MayFly-AI/stm32-pi4-hw/README.md

This repository contains 

- KiCad files for Raspberry Pi HAT Pose sensor
- KiCad files for STM32 Pose sensor
- STL files for camera enclosure
- STL files for enclosure for STM32 Pose sensor

We have used JLCPCB for producing the PCBs and the enclosures.
