MayFly-AI/stm32-pi4-hw/3d/pi4/base-pla.stl

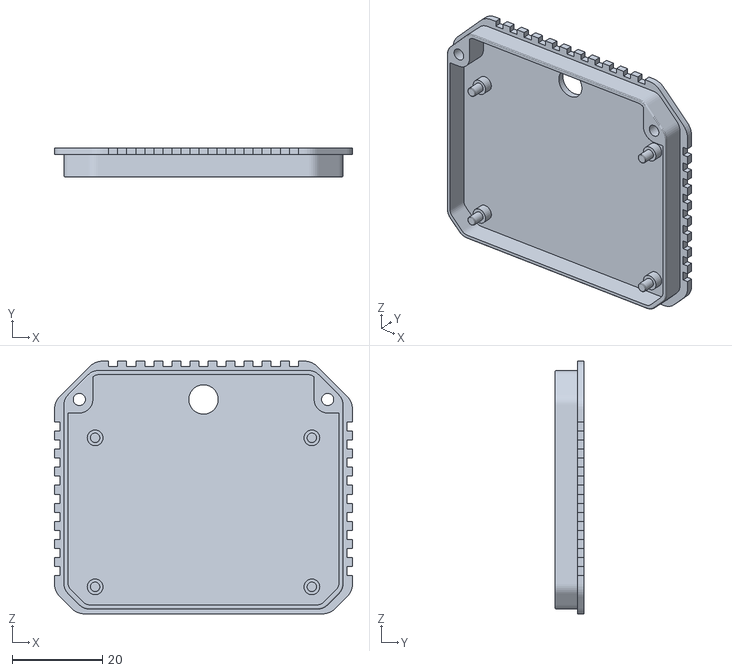
[picture p1: CAD file, 2024-03-07]
3d/pi4/base-pla.stl
66.0 x 6.50 x 56.0
