MayFly-AI/stm32-pi4-hw/3d/stm32/lid.stl

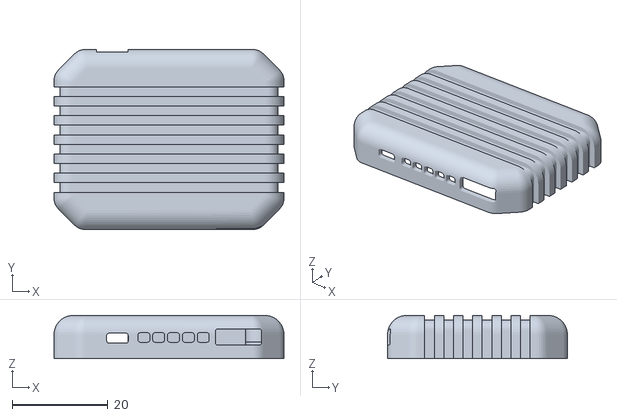
[picture p2: CAD file, 2024-02-19]
3d/stm32/lid.stl
48.0 x 37.6 x 9.00
