MayFly-AI/stm32-pi4-hw/3d/pi4/base-alu.stl

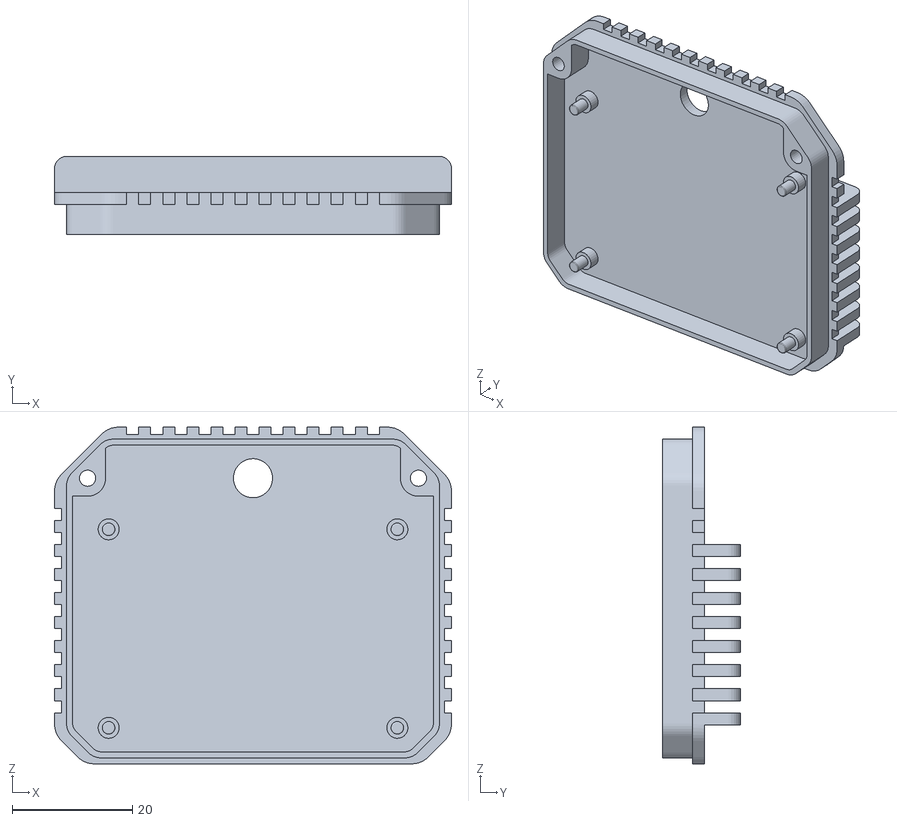
[picture p3: CAD file, 2024-03-07]
3d/pi4/base-alu.stl
66.0 x 13.0 x 56.0
