MayFly-AI/stm32-pi4-hw/3d/stm32/base.stl

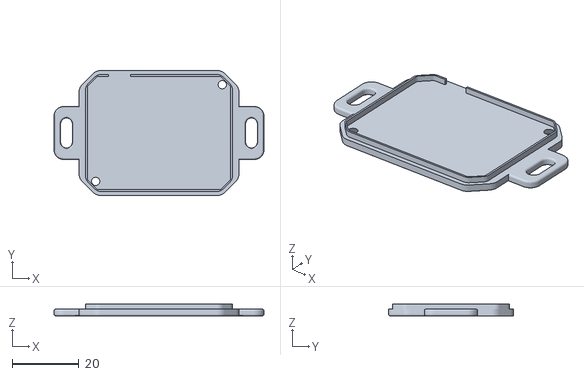
[picture p4: CAD file, 2024-02-19]
3d/stm32/base.stl
63.0 x 37.5 x 3.50
