MayFly-AI/stm32-pi4-hw/3d/pi4/lid.stl

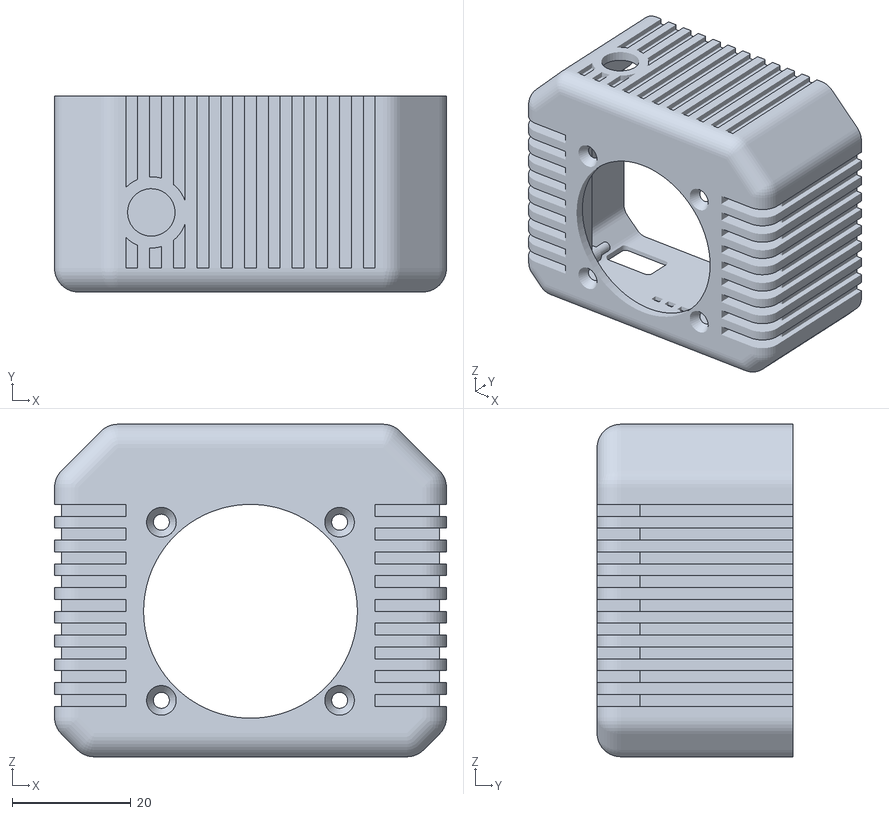
[picture p5: CAD file, 2024-02-29]
3d/pi4/lid.stl
66.0 x 33.0 x 56.0
