MayFly-AI/stm32-pi4-hw/(list of files, cad)

Other CAD files:
3d/pi4/pi4-sensorleap-pro.f3d
3d/stm32/stm32-sensorleap-box-v12.f3d
