MayFly-AI/stm32-pi4-hw/pcb/stm32f405-sensorleap-pro-v1/stm32f405-sensorleap-pro-v1.kicad_pcb

## KiCad design pcb/stm32f405-sensorleap-pro-v1/stm32f405-sensorleap-pro-v1.kicad_pcb (2024-02-20)

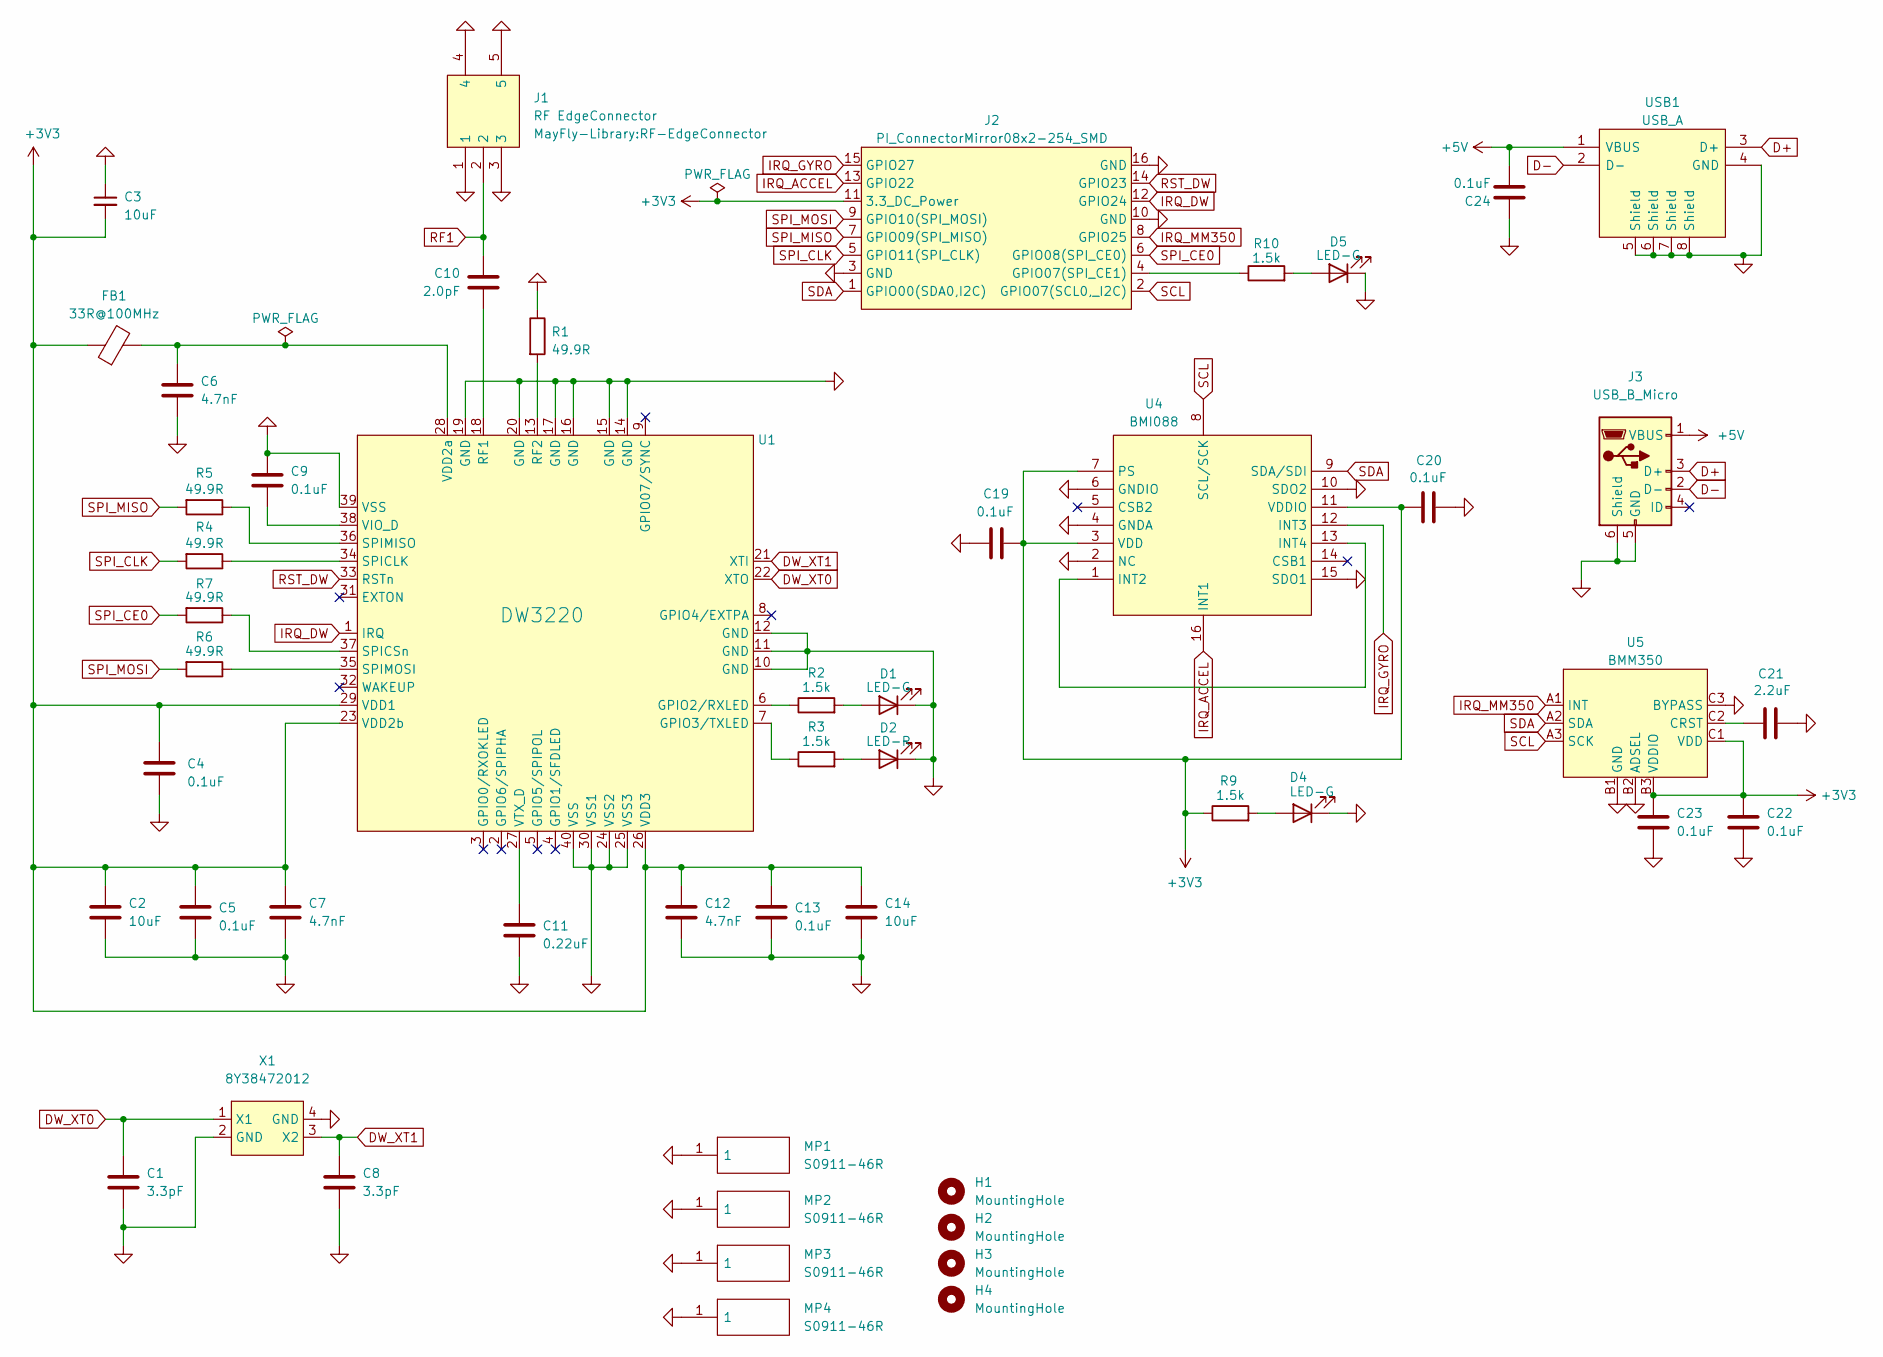
[picture p6: schematic stm32f405-sensorleap-pro-v1.kicad_sch]

Parts:
C1, C8: 3.3pF; C_0402_1005Metric; Mouser 81-GJM1555C1H3R3WB1D
C2, C14: 10uF; C_0402_1005Metric; Mouser 81-GRM155R61A106ME1D
C3: 10uF; C_0603_1608Metric; Mouser 81-GRM188R60J106ME47
C4, C5, C9, C13, C19, C20, C22, C23, C24: 0.1uF; C_0402_1005Metric; Mouser 810-C1005X7R1H104KBE
C6, C7, C12: 4.7nF; C_0402_1005Metric; Mouser 81-GCM155R71H472K37D
C10: 2.0pF; C_0402_1005Metric; Mouser 81-GJM1555C1H2R0WB1D
C11: 0.22uF; C_0402_1005Metric; Mouser 81-GRM155R71A224KE1D
C21: 2.2uF; C_0805_2012Metric; Mouser 81-GCM21BR71A225KA7L
D1, D4, D5: LED-G; LED_0603_1608Metric; LCSC C264453
D2: LED-R; LED_0603_1608Metric; LCSC C181863
FB1: 33R@100MHz; L_0402_1005Metric; Mouser 81-BLM15PX330SZ1D
H1, H2, H3, H4: MountingHole; MountingHole_2.5mm
J1: RF EdgeConnector; RF-EdgeConnector
J2: PI_ConnectorMirror08x2-254_SMD; PI_Connector08x2-254_SMD; LCSC C5160823
J3: USB_B_Micro; USB_Micro-AB_Molex_47590-0001; LCSC C136001
MP1, MP2, MP3, MP4: S0911-46R; S091146R; Mouser Part Number 855-S0911-46R
R1, R4, R5, R6, R7: 49.9R; R_0402_1005Metric; Mouser 667-ERJ-2RKF49R9X
R2, R3, R9, R10: 1.5k; R_0402_1005Metric; Mouser 667-ERJ-2RKF1501X
U1: DW3220; QFN-40_5x5_Pitch0.4mm; Mouser 772-DW3220TR13
U4: BMI088; Mouser :262-BMI088
U5: BMM350; LCSC C7496950
USB1: USB_A; 629104190121; Mouser Part Number 710-629104190121
X1: 8Y38472012; LCSC C2450882

Connections:
+3V3: C2.1, C3.2, C4.1, C5.1, C7.1, C12.1, C13.1, C14.1, C19.2, C20.1, C22.1, C23.1, FB1.1, J2.11 (3.3_DC_Power), R9.1, U1.23 (VDD2b), U1.26 (VDD3), U1.29 (VDD1), U4.3 (VDD), U4.7 (PS), U4.11 (VDDIO), U5.B3 (VDDIO), U5.C1 (VDD)
+5V: C24.2, J3.1 (VBUS), USB1.1 (VBUS)
D+: J3.3 (D+), USB1.3 (D+)
D-: J3.2 (D-), USB1.2 (D-)
DW_XT0: C1.1, U1.22 (XTO), X1.1 (X1)
DW_XT1: C8.1, U1.21 (XTI), X1.3 (X2)
GND: C1.2, C2.2, C3.1, C4.2, C5.2, C6.2, C7.2, C8.2, C9.1, C11.2, C12.2, C13.2, C14.2, C19.1, C20.2, C21.2, C22.2, C23.2, C24.1, D1.1 (K), D2.1 (K), D4.1 (K), D5.1 (K), J1.1, J1.3, J1.4, J1.5, J2.3 (GND), J2.10 (GND), J2.16 (GND), J3.5 (GND), J3.6 (Shield), MP1.1, MP2.1, MP3.1, MP4.1, R1.1, U1.10 (GND), U1.11 (GND), U1.12 (GND), U1.14 (GND), U1.15 (GND), U1.16 (GND), U1.17 (GND), U1.19 (GND), U1.20 (GND), U1.24 (VSS2), U1.25 (VSS3), U1.30 (VSS1), U1.39 (VSS), U1.40 (VSS), U4.2 (NC), U4.4 (GNDA), U4.6 (GNDIO), U4.10 (SDO2), U4.15 (SDO1), U5.B1 (GND), U5.B2 (ADSEL), U5.C3 (BYPASS), USB1.4 (GND), USB1.5 (Shield), USB1.6 (Shield), USB1.7 (Shield), USB1.8 (Shield), X1.2 (GND), X1.4 (GND)
IRQ_ACCEL: J2.13 (GPIO22), U4.16 (INT1)
IRQ_DW: J2.12 (GPIO24), U1.1 (IRQ)
IRQ_GYRO: J2.15 (GPIO27), U4.12 (INT3)
IRQ_MM350: J2.8 (GPIO25), U5.A1 (INT)
unnamed: D1.2 (A), R2.2
unnamed: D2.2 (A), R3.2
unnamed: D4.2 (A), R9.2
unnamed: D5.2 (A), R10.2
unnamed: J2.4 (GPIO07(SPI_CE1)), R10.1
unnamed: R2.1, U1.6 (GPIO2/RXLED)
unnamed: R3.1, U1.7 (GPIO3/TXLED)
unnamed: C10.2, U1.18 (RF1)
unnamed: R1.2, U1.13 (RF2)
unnamed: R4.1, U1.34 (SPICLK)
unnamed: R7.1, U1.37 (SPICSn)
unnamed: R5.1, U1.36 (SPIMISO)
unnamed: R6.1, U1.35 (SPIMOSI)
unnamed: C6.1, FB1.2, U1.28 (VDD2a)
unnamed: C9.2, U1.38 (VIO_D)
unnamed: C11.1, U1.27 (VTX_D)
unnamed: U4.1 (INT2), U4.13 (INT4)
unnamed: C21.1, U5.C2 (CRST)
RF1: C10.1, J1.2
RST_DW: J2.14 (GPIO23), U1.33 (RSTn)
SCL: J2.2 (GPIO07(SCL0,_I2C)), U4.8 (SCL/SCK), U5.A3 (SCK)
SDA: J2.1 (GPIO00(SDA0,I2C)), U4.9 (SDA/SDI), U5.A2 (SDA)
SPI_CE0: J2.6 (GPIO08(SPI_CE0)), R7.2
SPI_CLK: J2.5 (GPIO11(SPI_CLK)), R4.2
SPI_MISO: J2.7 (GPIO09(SPI_MISO)), R5.2
SPI_MOSI: J2.9 (GPIO10(SPI_MOSI)), R6.2

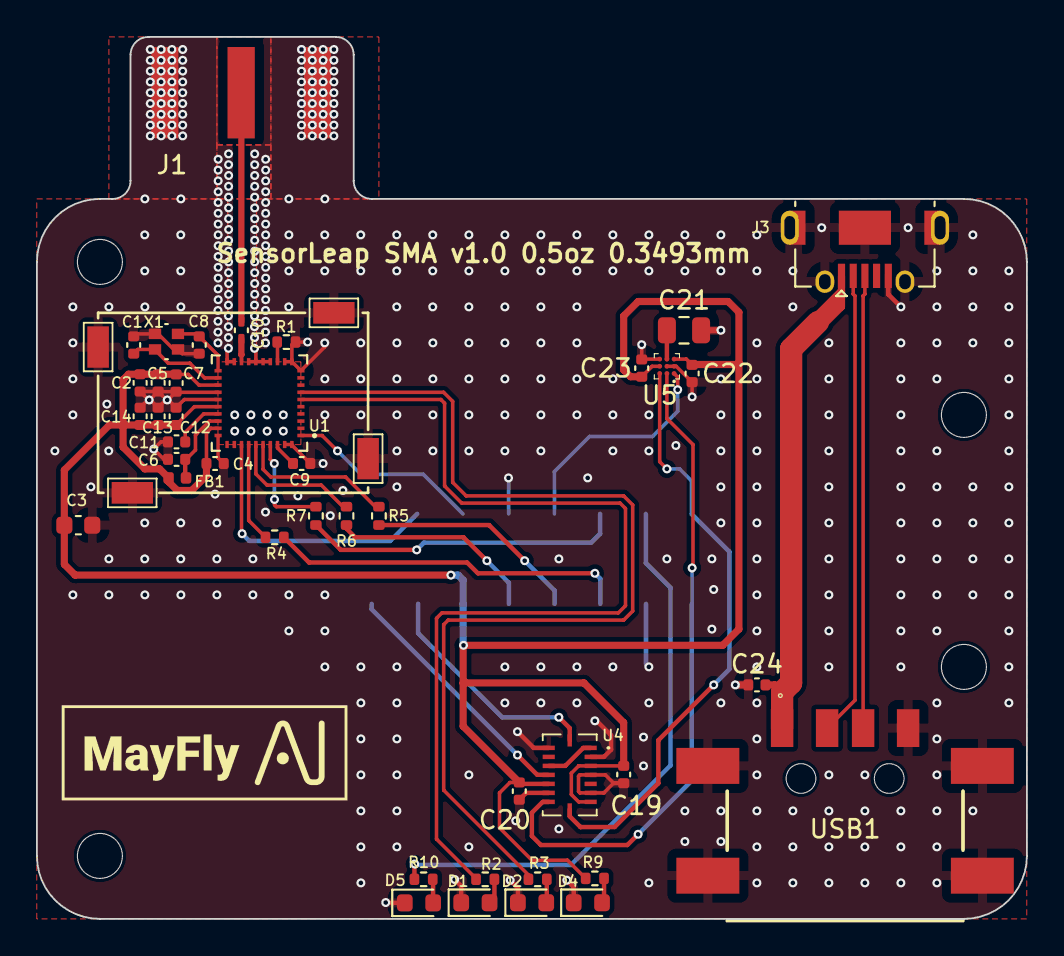
[picture p7: board stm32f405-sensorleap-pro-v1.kicad_pcb from above]

Board: 4 copper layers, 55.0 x 49.0 mm, 50 parts (1 on the bottom side), 37 nets.
