MayFly-AI/stm32-pi4-hw/pcb/stm32f405-sensorleap-v1/stm32f405-sensorleap-v1.kicad_pcb

## KiCad design pcb/stm32f405-sensorleap-v1/stm32f405-sensorleap-v1.kicad_pcb (2024-02-19)

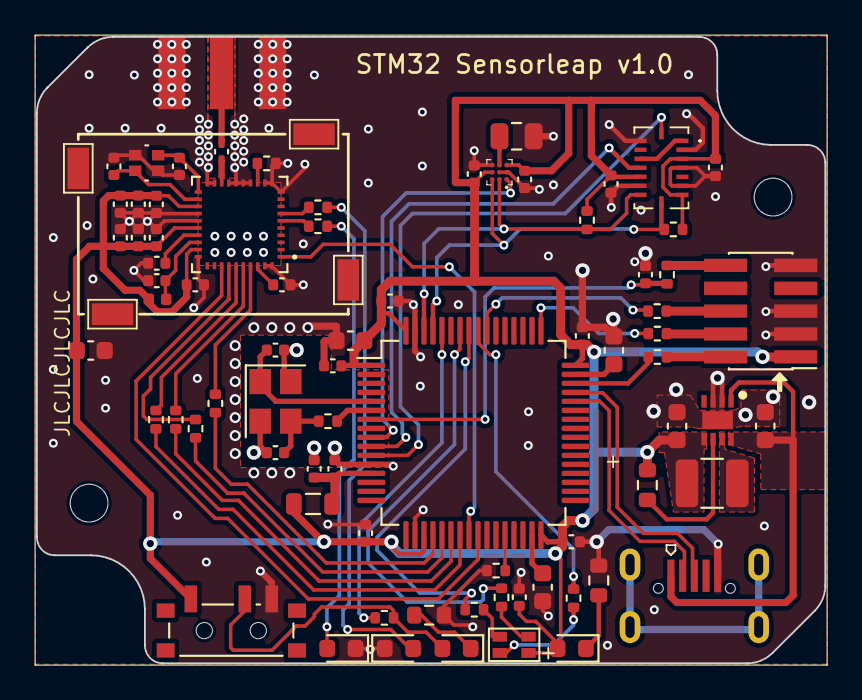
[picture p8: board stm32f405-sensorleap-v1.kicad_pcb from above]

Board: 4 copper layers, 43.8 x 34.8 mm, 82 parts (0 on the bottom side), 61 nets.

Parts:
C1, C301: 10uF; C_0603_1608Metric
C2, C14: 10uF; C_0402_1005Metric
C3, C9: 3.3pF; C_0402_1005Metric
C4, C6, C7, C13, C15, C16, C18, C19: 0.1uF; C_0402_1005Metric
C5, C8, C12: 4.7nF; C_0402_1005Metric
C10: 2.0pF; C_0402_1005Metric
C11: 0.22uF; C_0402_1005Metric
C20: 2.2uF; C_0805_2012Metric
C200: 4u7; C_0603_1608Metric
C201, C202, C203, C204, C205, C212, C400: 100n; C_0402_1005Metric
C206: 1u; C_0402_1005Metric
C207: 10n; C_0402_1005Metric
C208, C209: 2u2; C_0603_1608Metric
C210, C211: 12p; C_0402_1005Metric
C302: 22uF; C_0603_1608Metric
D1, D102: LED-G; LED_0603_1608Metric
D2, D200: LED-R; LED_0603_1608Metric
D201: 19-237/R6GHBHC-A01/2T; 19-237-R6GHBHC-A01-2T
FB1: 33R@100MHz; L_0402_1005Metric
FB200: 600 @ 600 MHz; L_0805_2012Metric
H1, H2: MountingHole; MountingHole_2.1mm
J1: RF EdgeConnector; CON-SMA-EDGE-SRP
J401: SWD; PinHeader_2x05_P1.27mm_Vertical_SMD
J402: USB_B_Micro; 5P Female Micro-B C40943
L1: 1uH; L_1210_3225Metric
MP1, MP2, MP3, MP4: S0911-46R; S091146R
R1, R2, R3, R4, R5: 49.9R; R_0402_1005Metric
R6, R206, R207, R208: 1k; R_0402_1005Metric
R7: 1.5k; R_0402_1005Metric
R105: 1k5; R_0603_1608Metric
R200: 47R; R_0402_1005Metric
R201, R203: 10k; R_0402_1005Metric
R202: 1k; R_0603_1608Metric
R204, R205: 2k2; R_0402_1005Metric
R301: 180k; R_0603_1608Metric
R400, R401, R402, R403: 22R; R_0402_1005Metric
SW200: SW_SPDT; SW_SPDT_PCM12
U1: DW3220; QFN-40_5x5_Pitch0.4mm
U2: BMI088
U3: BMM350
U200: STM32F405RGT6; LQFP-64_10x10mm_P0.5mm
U301: TPS62082; SON50P200X200X80-9N
X1: 8Y38472012
Y200: 16MHz; Crystal_SMD_3225-4Pin_3.2x2.5mm

Connections:
+3.3VA: C206.1, C207.1, FB200.1, U200.13 (VDDA)
+3V3: C1.2, C2.1, C4.1, C6.1, C8.1, C12.1, C13.1, C14.1, C15.2, C16.1, C18.1, C19.1, C200.1, C201.1, C202.1, C203.1, C204.1, C205.1, C212.1, C302.1, D102.2 (A), D201.4 (A), FB1.1, FB200.2, J401.1, L1.2, R204.1, R205.1, R301.2, SW200.1 (A), U1.23 (VDD2b), U1.26 (VDD3), U1.29 (VDD1), U2.3 (VDD), U2.7 (PS), U2.11 (VDDIO), U3.B3 (VDDIO), U3.C1 (VDD), U200.1 (VBAT), U200.19 (VDD), U200.32 (VDD), U200.48 (VDD), U200.64 (VDD), U301.5 (VOS)
+5V: C301.1, J402.1 (VBUS), U301.1 (EN), U301.8 (VIN)
BOOT0: R201.2, U200.60 (BOOT0)
BOOT1: R203.1, U200.28 (PB2)
DW_XT0: C3.1, U1.22 (XTO), X1.1 (X1)
DW_XT1: C9.1, U1.21 (XTI), X1.3 (X2)
GND: C1.1, C2.2, C3.2, C4.2, C5.2, C6.2, C7.1, C8.2, C9.2, C11.2, C12.2, C13.2, C14.2, C15.1, C16.2, C18.2, C19.2, C20.2, C200.2, C201.2, C202.2, C203.2, C204.2, C205.2, C206.2, C207.2, C208.2, C209.2, C210.2, C211.2, C212.2, C301.2, C302.2, C400.2, D1.1 (K), D2.1 (K), J1.1, J1.3, J1.4, J1.5, J401.3, J401.5, J401.9, J402.5 (GND), MP1.1, MP2.1, MP3.1, MP4.1, R5.1, R105.2, R202.1, R203.2, SW200.3 (C), U1.10 (GND), U1.11 (GND), U1.12 (GND), U1.14 (GND), U1.15 (GND), U1.16 (GND), U1.17 (GND), U1.19 (GND), U1.20 (GND), U1.24 (VSS2), U1.25 (VSS3), U1.30 (VSS1), U1.39 (VSS), U1.40 (VSS), U2.2 (NC), U2.4 (GNDA), U2.6 (GNDIO), U2.10 (SDO2), U2.15 (SDO1), U3.B1 (GND), U3.B2 (ADSEL), U3.C3 (BYPASS), U200.12 (VSSA), U200.18 (VSS), U200.63 (VSS), U301.2 (GND), U301.3 (MODE), U301.9 (GND), X1.2 (GND), X1.4 (GND), Y200.2, Y200.4
HSE_IN: C210.1, U200.5 (PH0), Y200.1
HSE_OUT: R200.1, U200.6 (PH1)
I2C1_SCL: R204.2, U2.8 (SCL/SCK), U3.A3 (SCK), U200.61 (PB8)
I2C1_SDA: R205.2, U2.9 (SDA/SDI), U3.A2 (SDA), U200.62 (PB9)
INT_ACC: U2.16 (INT1), U200.11 (PC3)
INT_GYR: U2.12 (INT3), U200.10 (PC2)
IRQ_DW: U1.1 (IRQ), U200.24 (PC4)
IRQ_MM350: U3.A1 (INT), U200.9 (PC1)
NRST: C400.1, R403.1, U200.7 (NRST)
unnamed: C211.1, R200.2, Y200.3
unnamed: D1.2 (A), R6.2
unnamed: D2.2 (A), R7.2
unnamed: D102.1 (K), R105.1
unnamed: D200.2 (A), R201.1, SW200.2 (B)
unnamed: D200.1 (K), R202.2
unnamed: D201.3 (BK), R208.1
unnamed: D201.2 (GK), R207.1
unnamed: D201.1 (RK), R206.1
unnamed: J401.2, R400.2
unnamed: J401.4, R401.2
unnamed: J401.6, R402.2
unnamed: J401.10, R403.2
unnamed: R6.1, U1.6 (GPIO2/RXLED)
unnamed: R7.1, U1.7 (GPIO3/TXLED)
unnamed: C10.2, U1.18 (RF1)
unnamed: R5.2, U1.13 (RF2)
unnamed: R2.1, U1.34 (SPICLK)
unnamed: R3.1, U1.37 (SPICSn)
unnamed: R1.1, U1.36 (SPIMISO)
unnamed: R4.1, U1.35 (SPIMOSI)
unnamed: C5.1, FB1.2, U1.28 (VDD2a)
unnamed: C7.2, U1.38 (VIO_D)
unnamed: C11.1, U1.27 (VTX_D)
unnamed: U2.1 (INT2), U2.13 (INT4)
unnamed: C20.1, U3.C2 (CRST)
unnamed: C208.1, U200.31 (VCAP_1)
unnamed: C209.1, U200.47 (VCAP_2)
unnamed: R301.1, U301.6 (PG)
unnamed: L1.1, U301.7 (SW)
RF1: C10.1, J1.2
RST_DW: U1.33 (RSTn), U200.25 (PC5)
SPI1_!CS_ACC: R3.2, U200.20 (PA4)
SPI1_MISO: R1.2, U200.22 (PA6)
SPI1_MOSI: R4.2, U200.23 (PA7)
SPI1_SCK: R2.2, U200.21 (PA5)
SWCLK: R401.1, U200.49 (PA14)
SWDIO: R400.1, U200.46 (PA13)
SWO: R402.1, U200.55 (PB3)
TIM3_CH1: R206.2, U200.56 (PB4)
TIM3_CH2: R207.2, U200.57 (PB5)
TIM4_CH1: R208.2, U200.58 (PB6)
USB_D+: J402.3 (D+), U200.45 (PA12)
USB_D-: J402.2 (D-), U200.44 (PA11)
