MayFly-AI/stm32-pi4-hw/(commit log)

2024-02-20 pro version
    [SensorLeapSMA-BOM.csv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]
2024-02-29 adjust pi4 box to fit pro board
    [base.stl, lid.stl, pi4-sensorleap-box-v12.f3d]
2024-03-07 pi4 geometry files and gitignore kicad cache and backup
    [base-alu.stl, base-pla.stl, pi4-sensorleap-pro.f3d]
